Fahofah/arduino-outdoor-temperature-sensors/media/images/3.jpeg

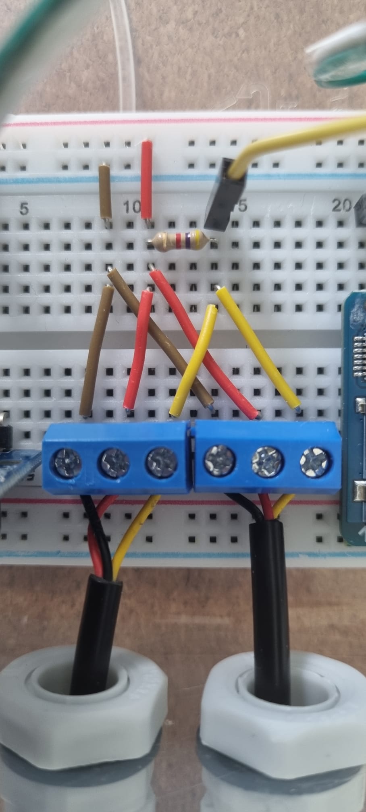
media/images/3.jpeg
